JimMacA/WaveDeck/WaveDeckCardBot.pdf

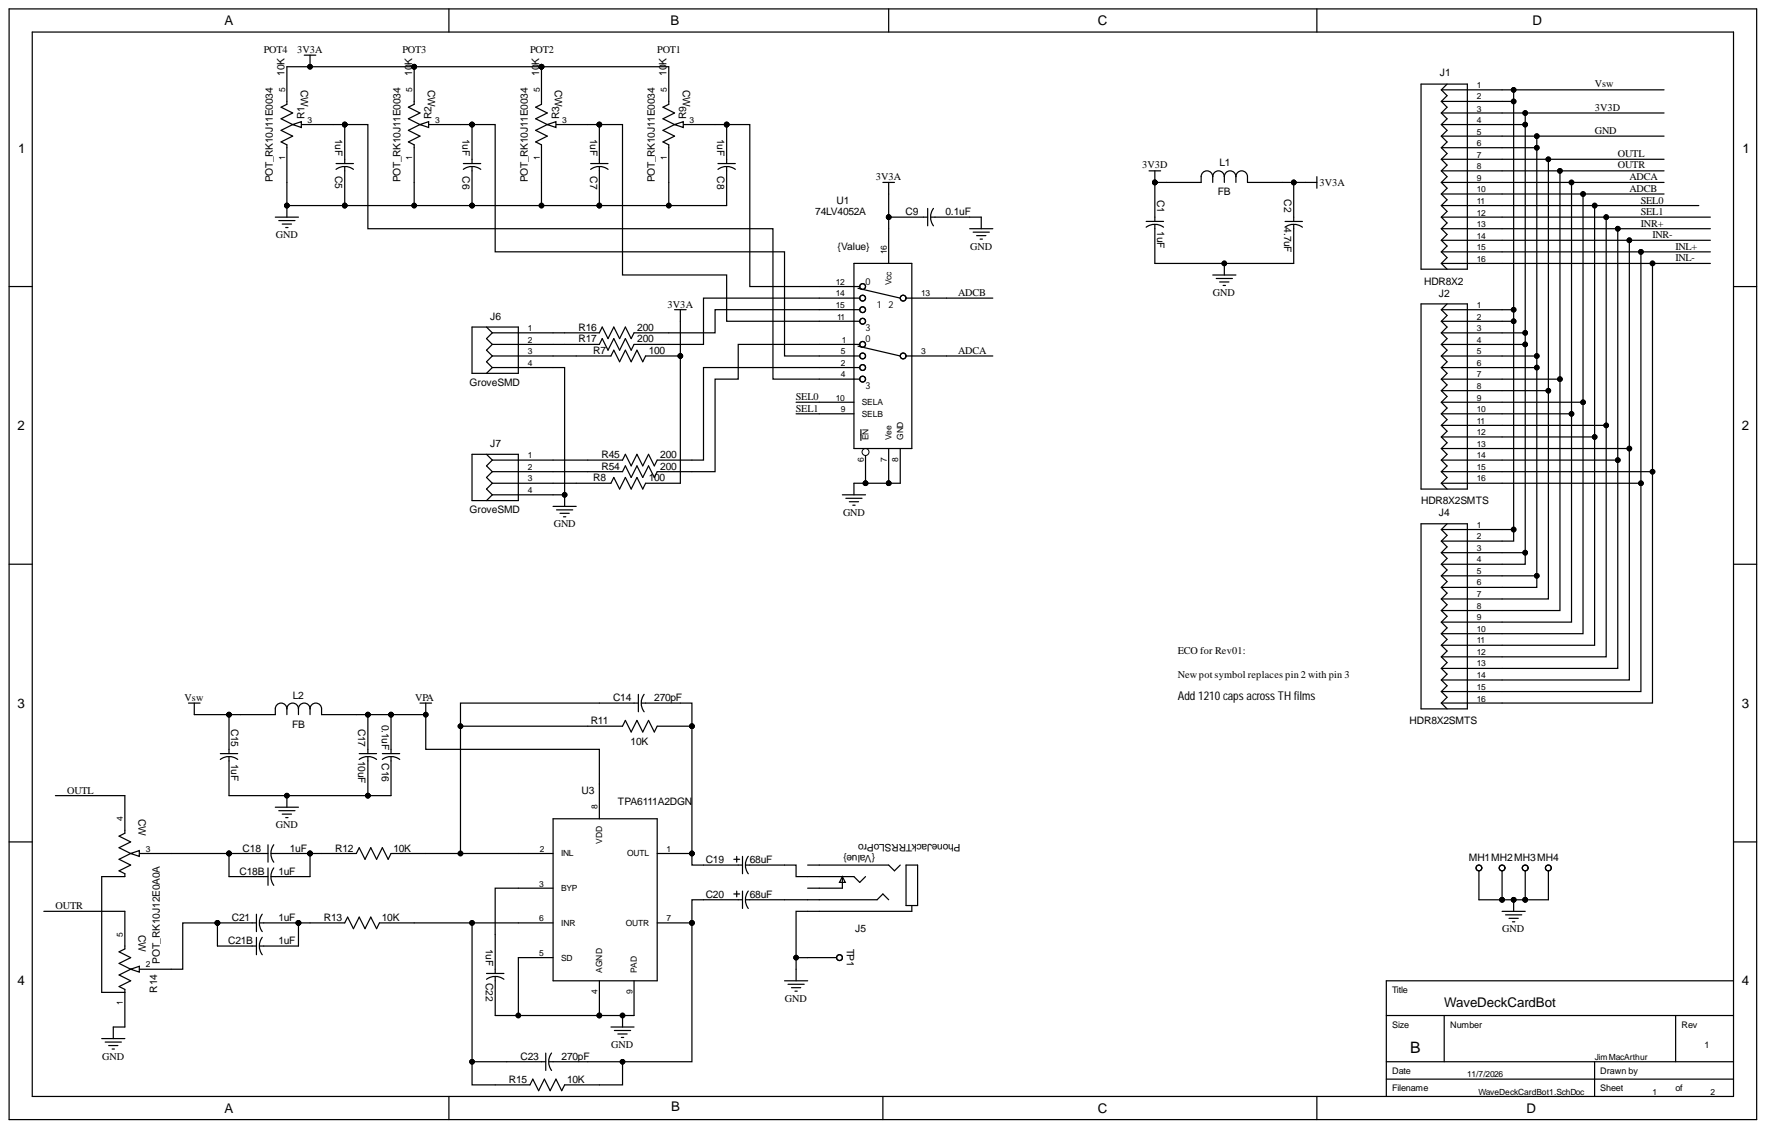
[picture p1: page 1]

11
12
13
14

New potsymbol replaces pin 2 with pin 3
Add 1210 caps across TH films

INL 2

BYP 3

INR 6 SD 5

Size B | Number JimMacArthur | Rev 1

Date 11/7/2026 | Drawn by

Filename WaveDeckCardBot1.SchDoc | Sheet 1 of 2

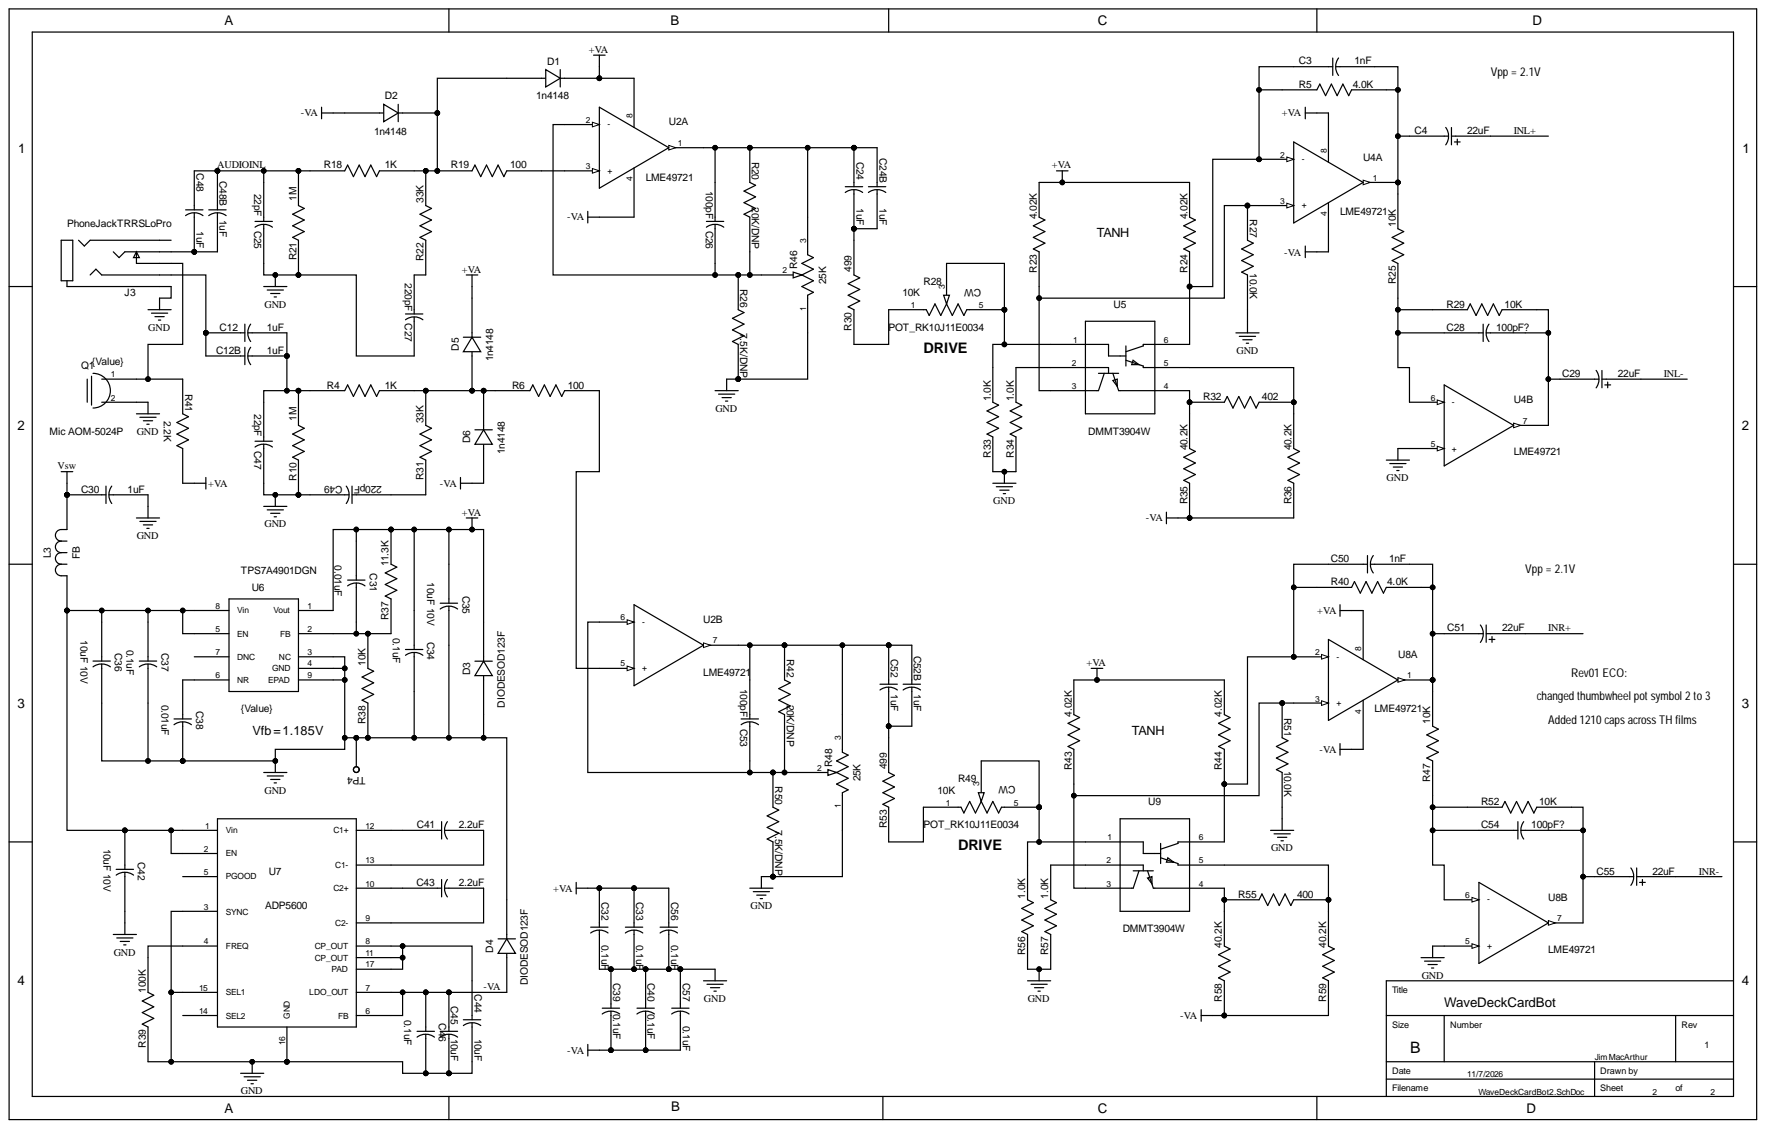
[picture p2: page 2]

changed thumbwheel pot symbol 2 to 3

Added 1210 caps across TH films

Size B | Number JimMacArthur | Rev 1

Date 11/7/2026 | Drawn by
