JimMacA/WaveDeck/WaveDeckCardTop.pdf

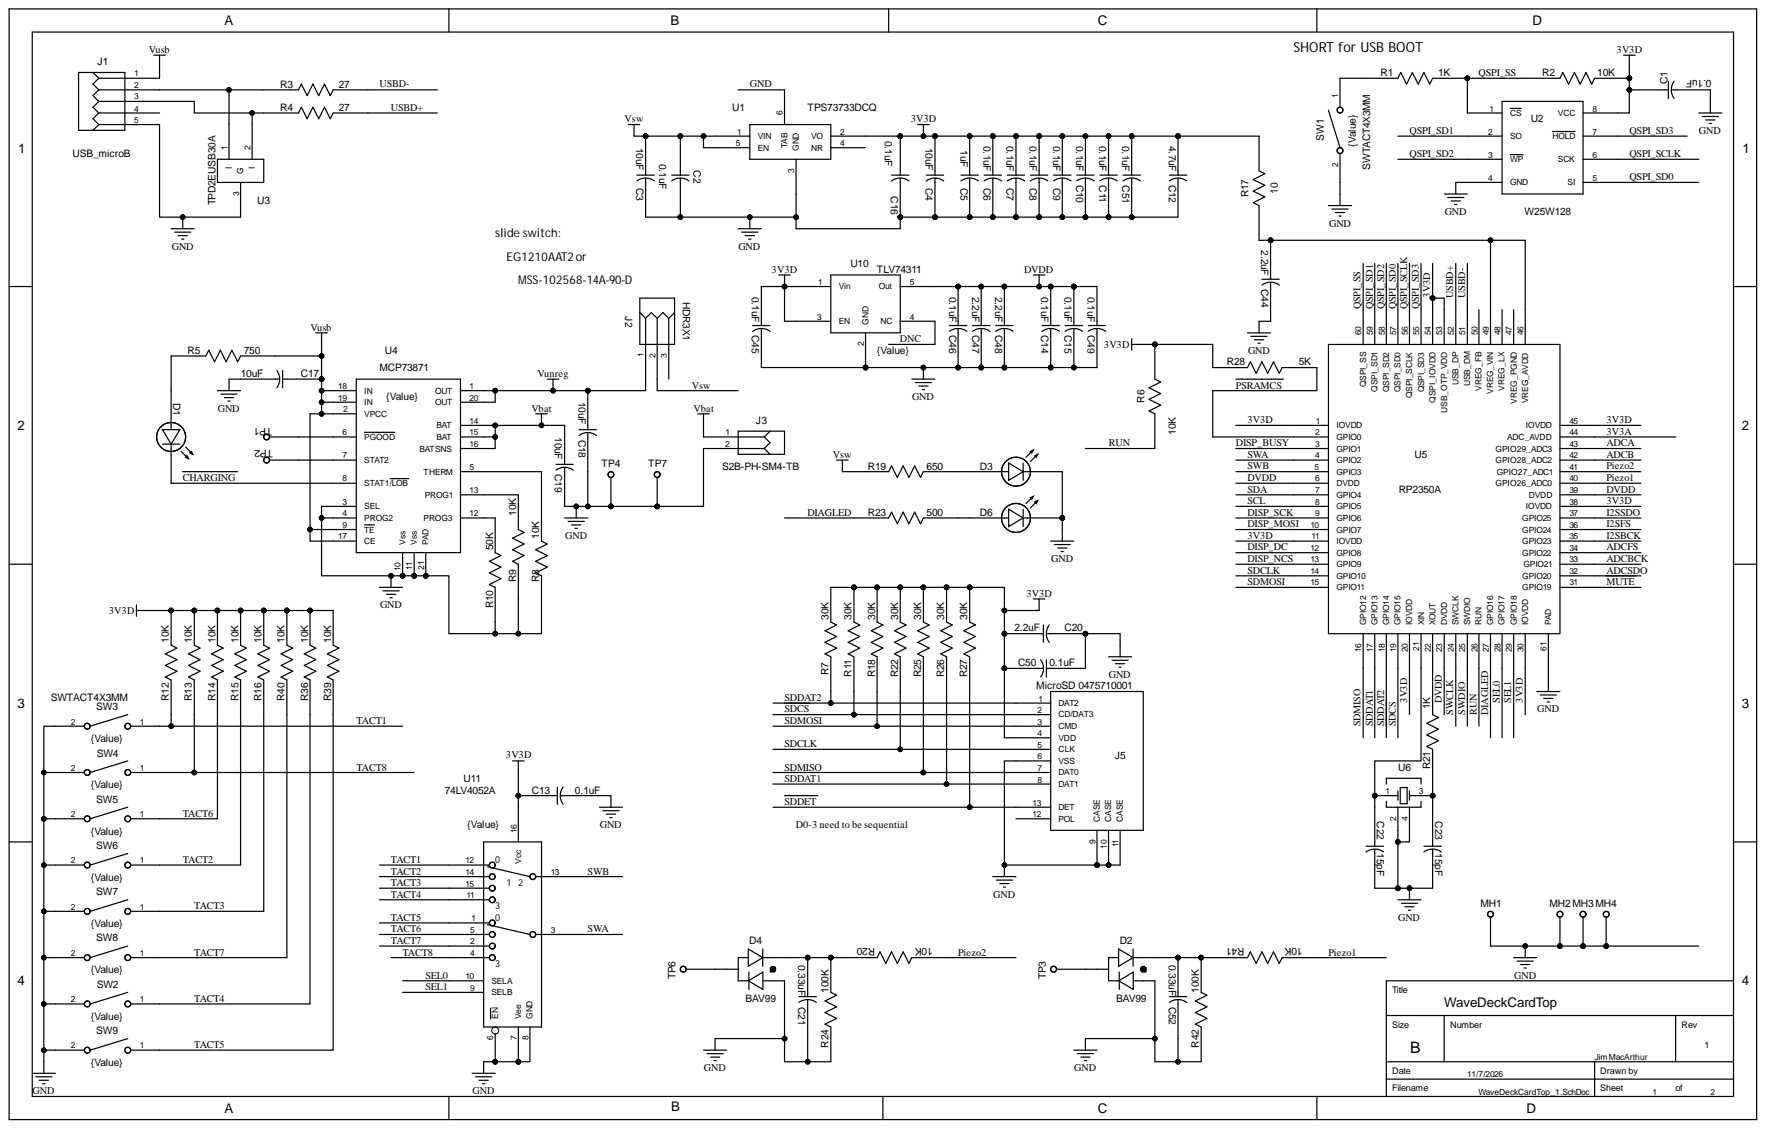
[picture p3: page 1]

SHORT for USB BOOT

TE 9 PROG2 4

D0-3 need to be sequential

Size B | Number JimMacArthur | Rev 1

Date 11/7/2026 | Drawn by

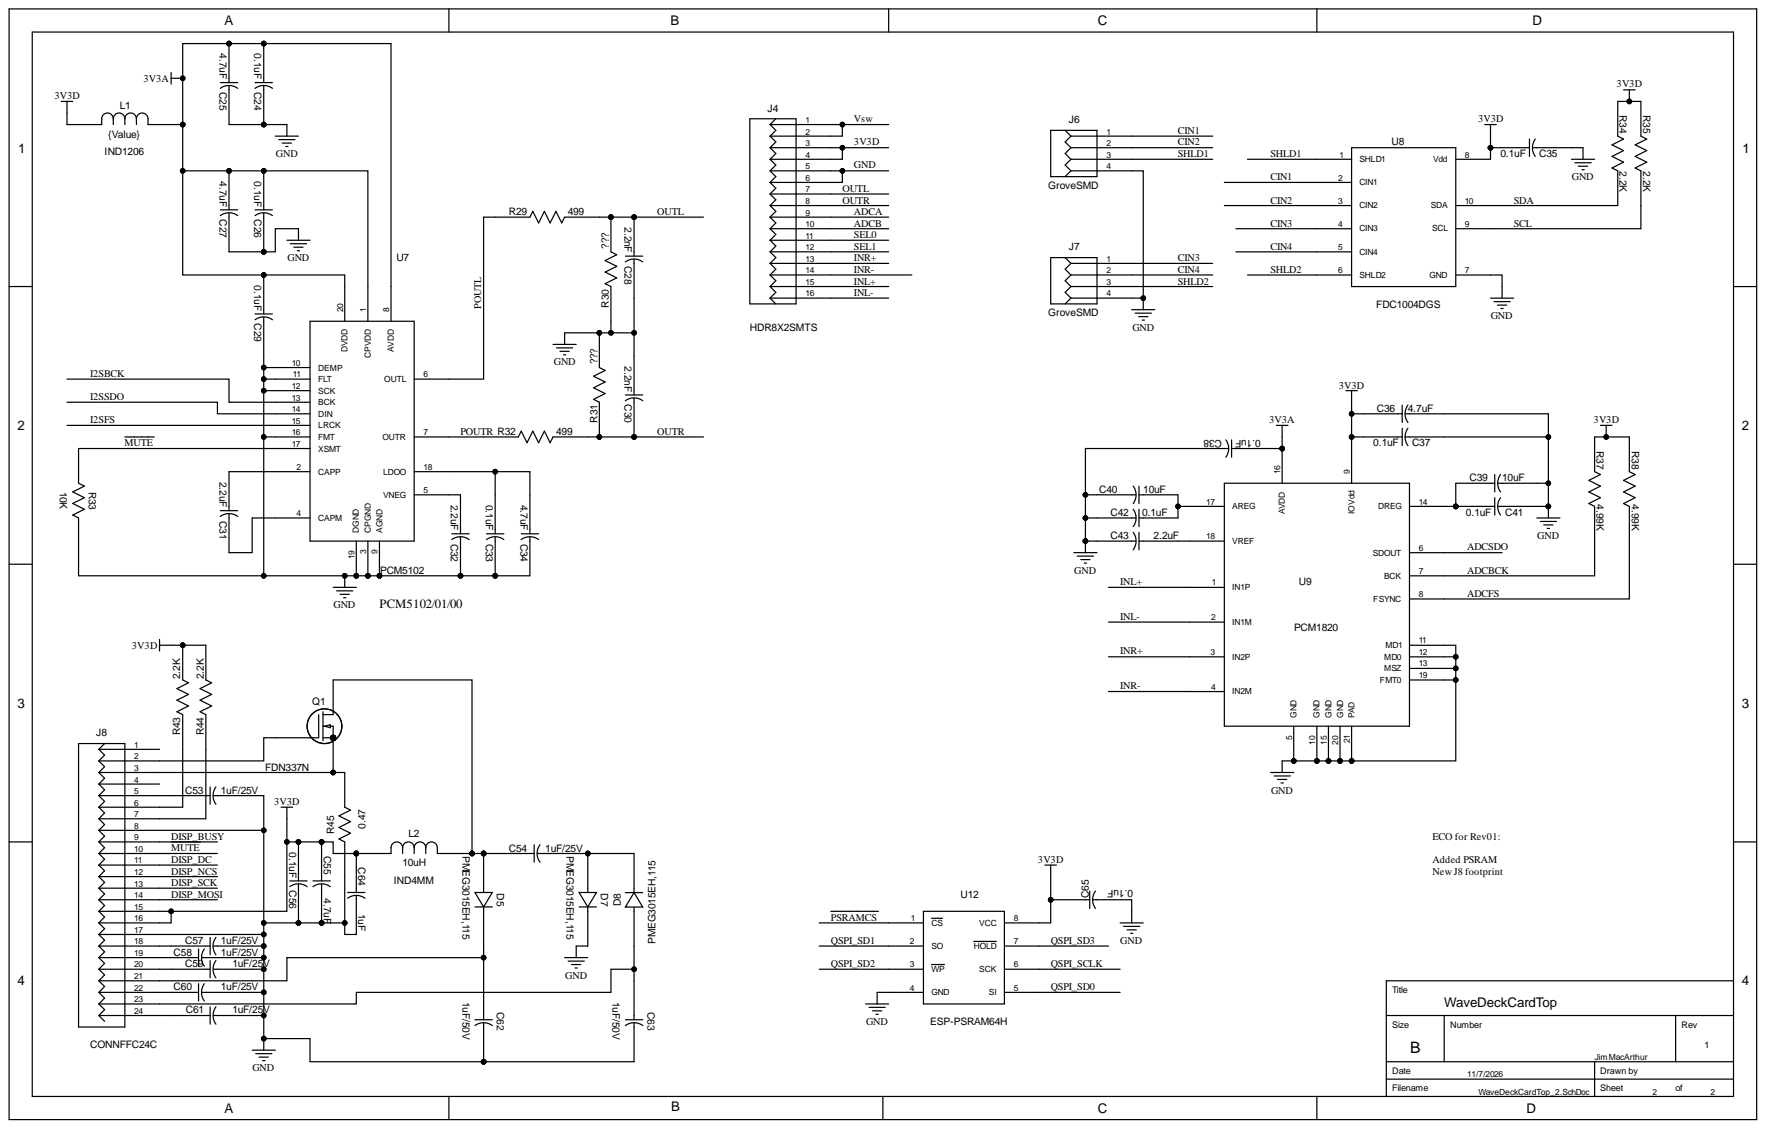
[picture p4: page 2]

1 3
1 4
