JimMacA/WaveDeck/WDCard_Grains_TapTest/resources.cc

// Copyright 2014 Emilie Gillet.
//
// Author: Emilie Gillet (emilie.o.gillet@gmail.com)
//
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
// See http://creativecommons.org/licenses/MIT/ for more information.
//
// -----------------------------------------------------------------------------
//
// Resources definitions.
//
// Automatically generated with:
// make resources


#include "resources.h"



const float src_filter_1x_2_31[] = {
   6.826286541e-03,  1.617306168e-02, -9.023930288e-03, -1.314720136e-02,
   2.771050661e-03,  2.178528721e-02,  3.540864731e-03, -2.954351590e-02,
  -1.652225270e-02,  3.723501469e-02,  3.990208332e-02, -4.362991064e-02,
  -8.919302357e-02,  4.787067784e-02,  3.056656246e-01,  4.385797663e-01,
   3.056656246e-01,  4.787067784e-02, -8.919302357e-02, -4.362991064e-02,
   3.990208332e-02,  3.723501469e-02, -1.652225270e-02, -2.954351590e-02,
   3.540864731e-03,  2.178528721e-02,  2.771050661e-03, -1.314720136e-02,
  -9.023930288e-03,  1.617306168e-02,  6.826286541e-03,
};
const float src_filter_1x_2_45[] = {
  -6.928606892e-04, -5.894682972e-03,  4.393903915e-04,  5.352009980e-03,
   1.833575577e-03, -7.103853054e-03, -5.275577768e-03,  7.999060050e-03,
   1.029879712e-02, -7.191125897e-03, -1.675763381e-02,  3.628265970e-03,
   2.423749384e-02,  4.020326715e-03, -3.208822586e-02, -1.775516900e-02,
   3.947412082e-02,  4.200610725e-02, -4.553678524e-02, -9.270618476e-02,
   4.952442102e-02,  3.157869177e-01,  4.528032253e-01,  3.157869177e-01,
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
  -6.346690975e+00, -6.292869580e+00, -6.237600948e+00, -6.180984198e+00,
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
};


const float* lookup_table_table[] = {
  lut_sin,
  lut_window,
  lut_xfade_in,
  lut_xfade_out,
  lut_sine_window_4096,
  lut_cutoff,
  lut_grain_size,
  lut_quantized_pitch,
};
