JimMacA/WaveDeck/(commit log)

2026-11-08 Add files via upload
    Schematic of WaveDeck bottom board.
2026-11-08 Add files via upload
    Schematic of top WaveDeck board
